luclu7/luclu-electronic/static/img/kvb/3bis-7seg-tm1637.jpg

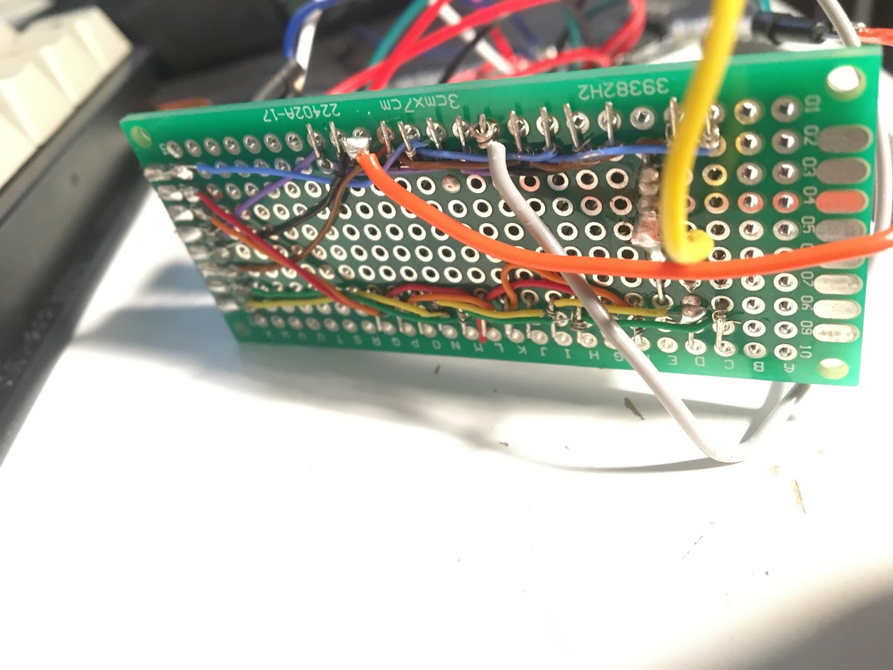
static/img/kvb/3bis-7seg-tm1637.jpg
