luclu7/luclu-electronic/static/img/kvb/7segments.jpg

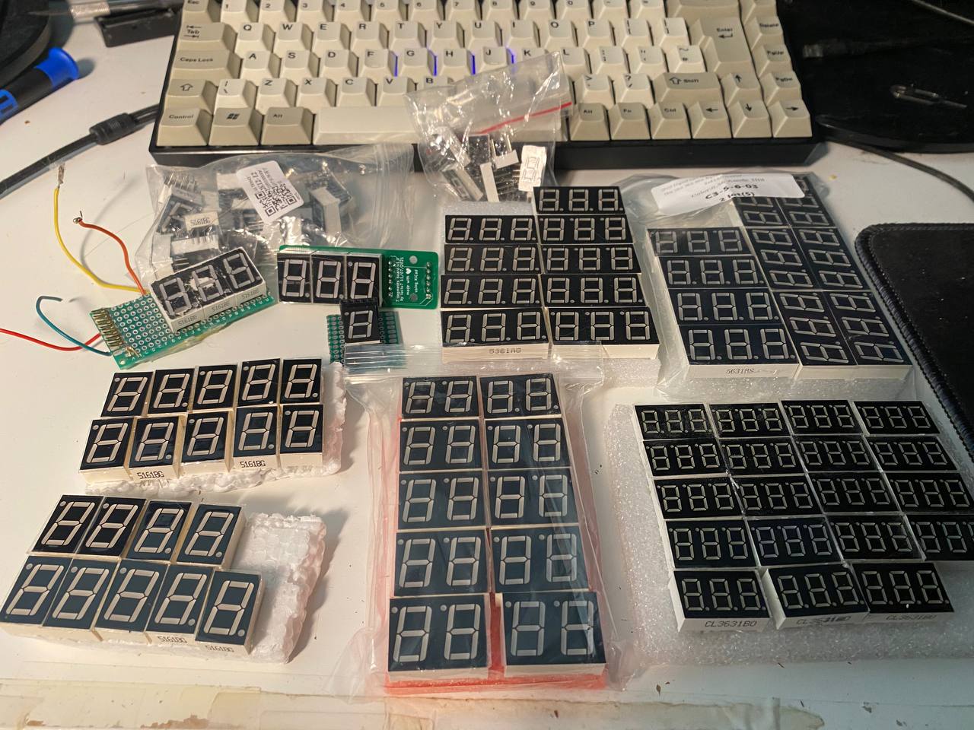
static/img/kvb/7segments.jpg
