luclu7/luclu-electronic/static/img/kvb/aliexpress-1.png

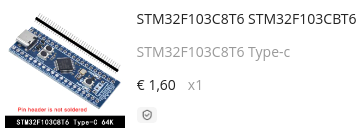
static/img/kvb/aliexpress-1.png
