luclu7/luclu-electronic/static/img/kvb/arriere-boitier-1.jpg

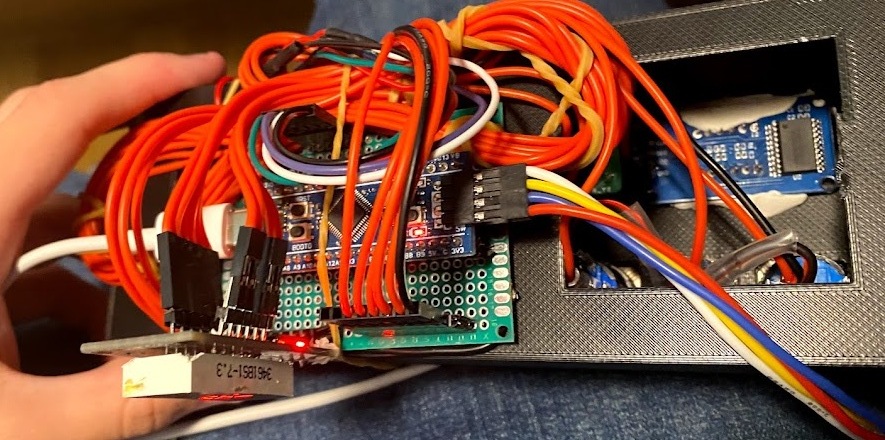
static/img/kvb/arriere-boitier-1.jpg
