luclu7/luclu-electronic/static/img/kvb/arriere-boitier-2.jpg

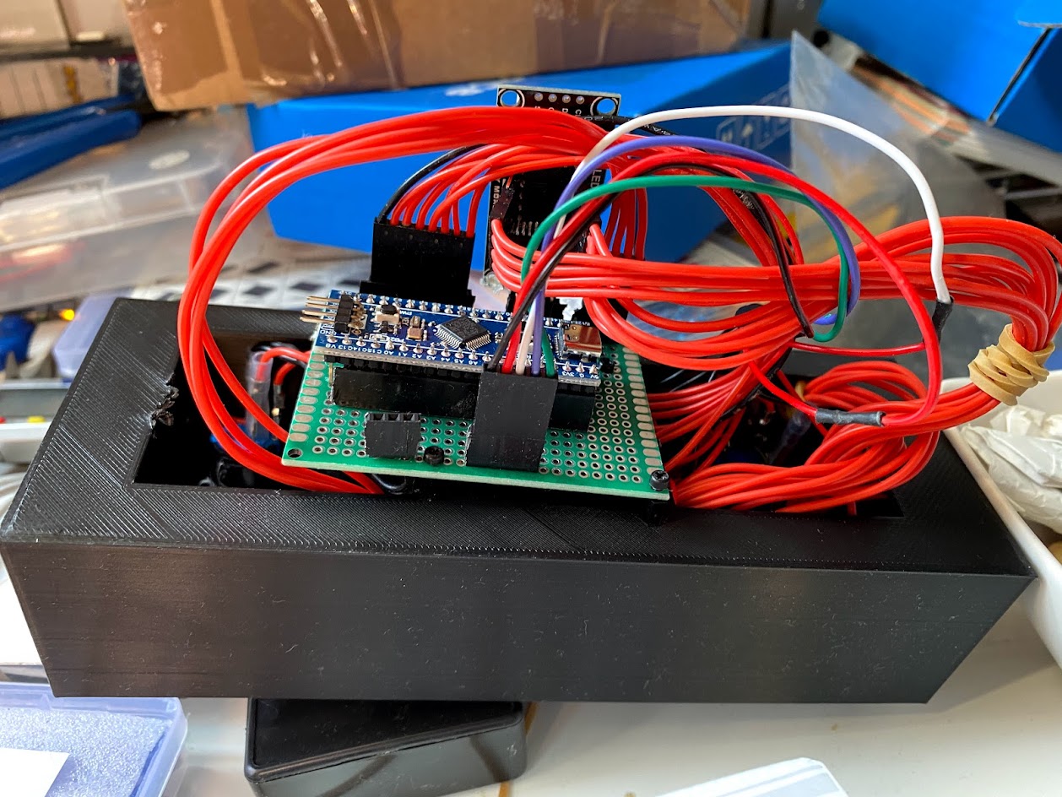
static/img/kvb/arriere-boitier-2.jpg
