luclu7/luclu-electronic/static/img/kvb/breadboard.jpg

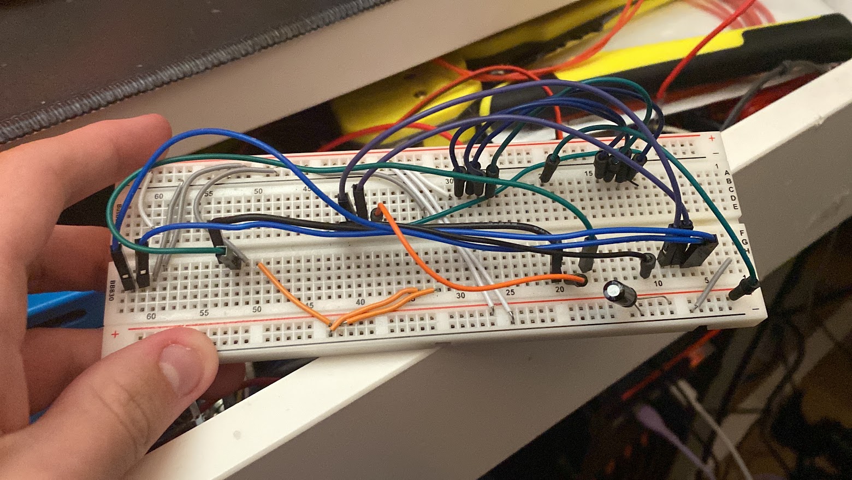
static/img/kvb/breadboard.jpg
