luclu7/luclu-electronic/static/img/kvb/kvb-1ere-impression.jpg

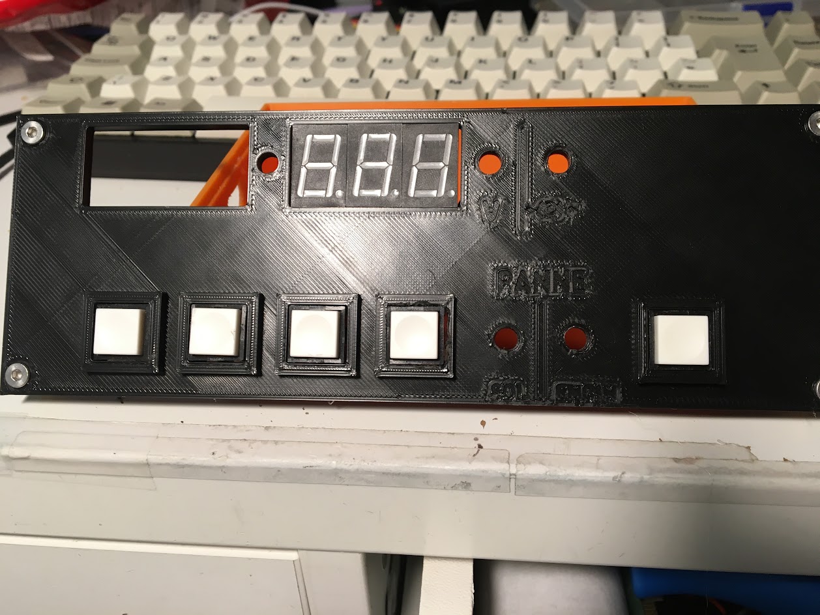
static/img/kvb/kvb-1ere-impression.jpg
