luclu7/luclu-electronic/static/img/kvb/kvb-20-mai.png

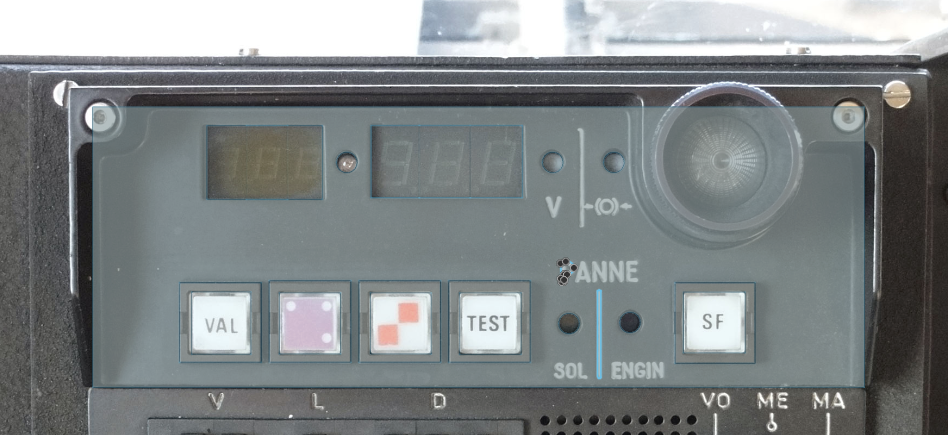
static/img/kvb/kvb-20-mai.png
