luclu7/luclu-electronic/static/img/kvb/kvb-29-mai.png

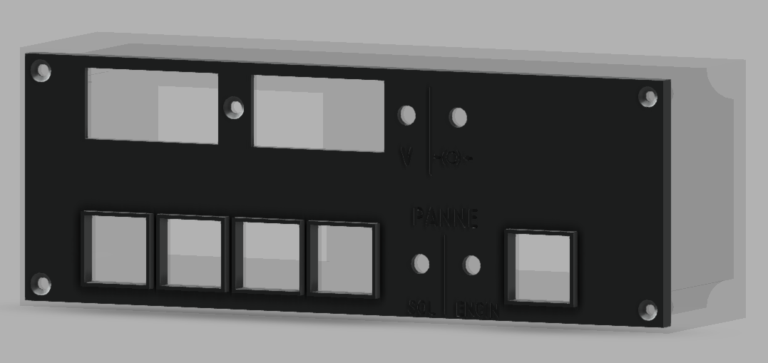
static/img/kvb/kvb-29-mai.png
