luclu7/luclu-electronic/static/img/kvb/kvb-final.jpg

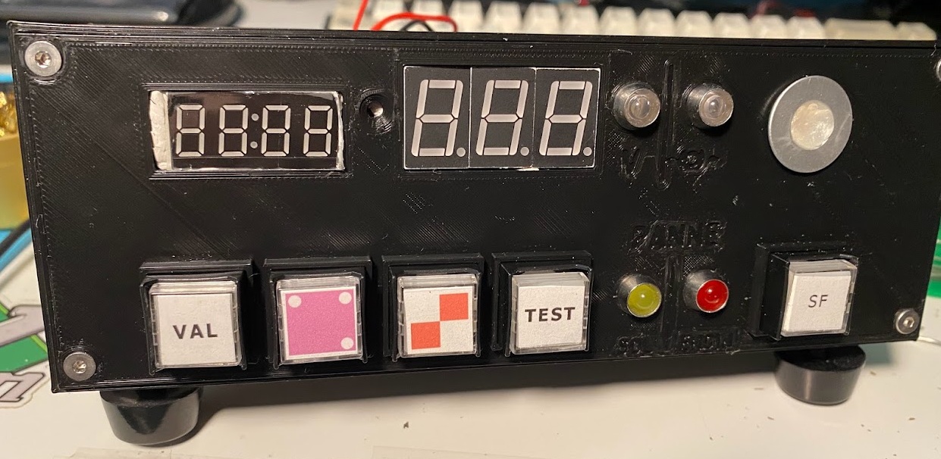
static/img/kvb/kvb-final.jpg
