luclu7/luclu-electronic/static/img/kvb/kvb-led.jpg

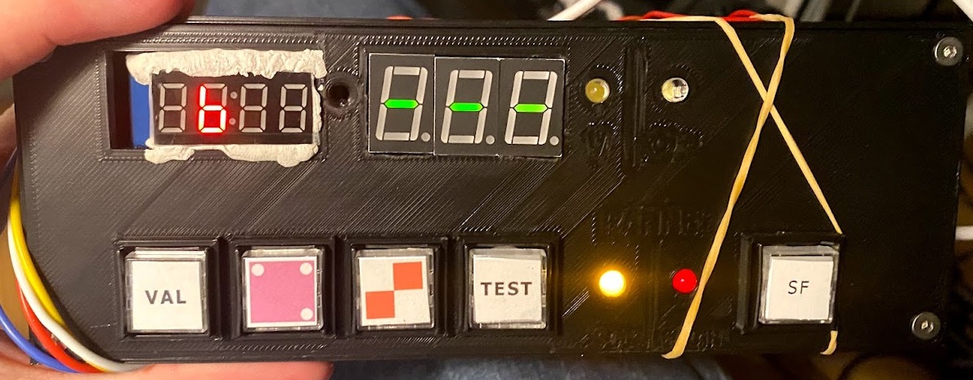
static/img/kvb/kvb-led.jpg
