luclu7/luclu-electronic/static/img/kvb/kvb-rio.jpg

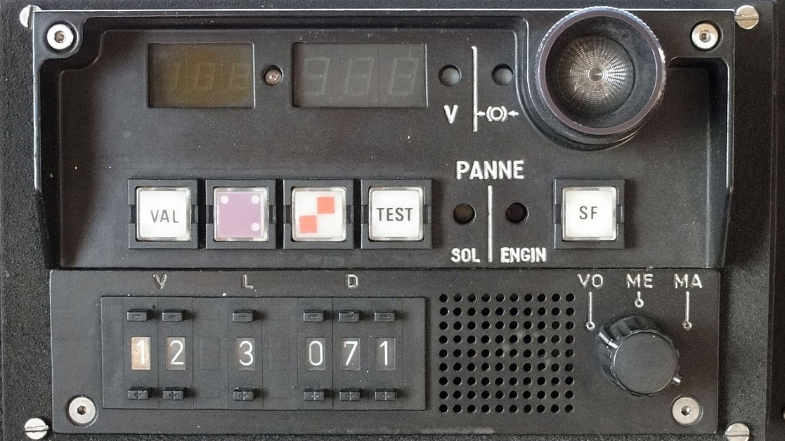
static/img/kvb/kvb-rio.jpg
