luclu7/luclu-electronic/static/img/kvb/kvb-sur-bureau.jpg

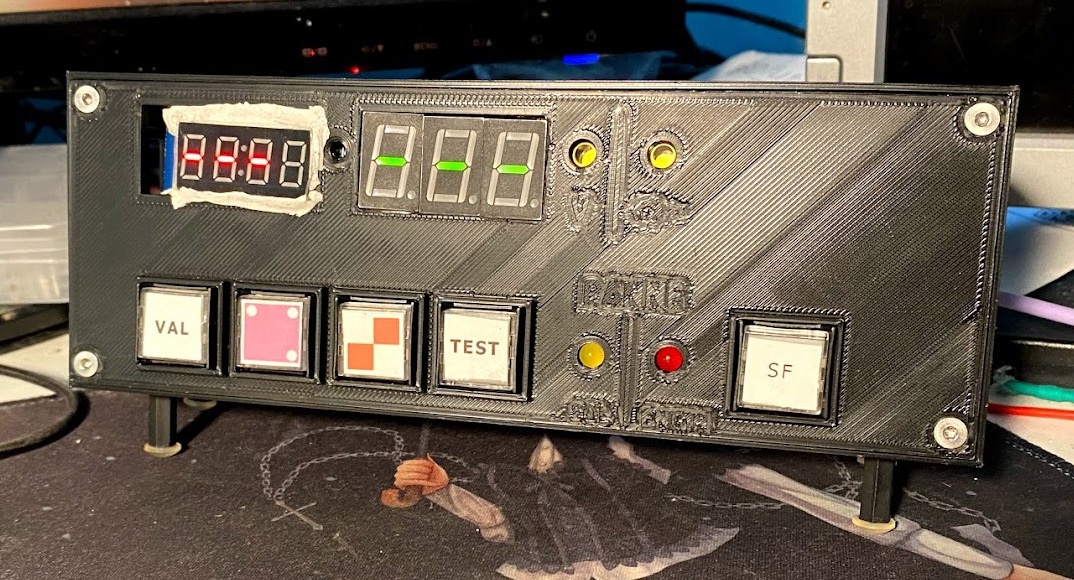
static/img/kvb/kvb-sur-bureau.jpg
