luclu7/luclu-electronic/static/img/kvb/kvb-ts-dans-train.jpg

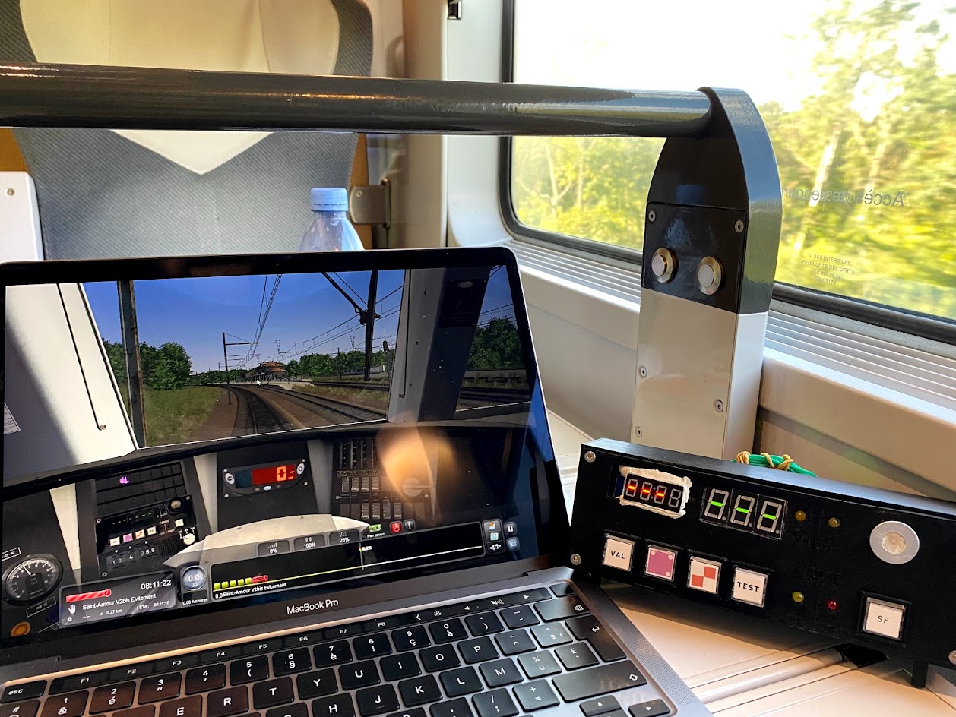
static/img/kvb/kvb-ts-dans-train.jpg
