luclu7/luclu-electronic/static/img/kvb/pcb1.png

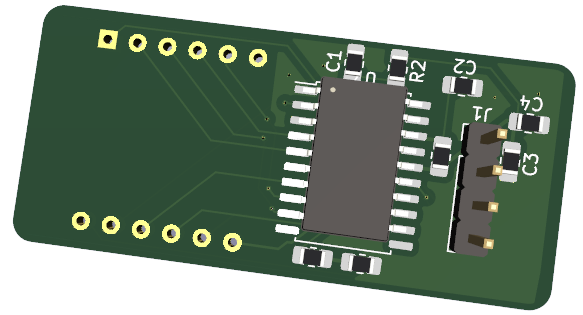
static/img/kvb/pcb1.png
