luclu7/luclu-electronic/static/img/kvb/pcb2.png

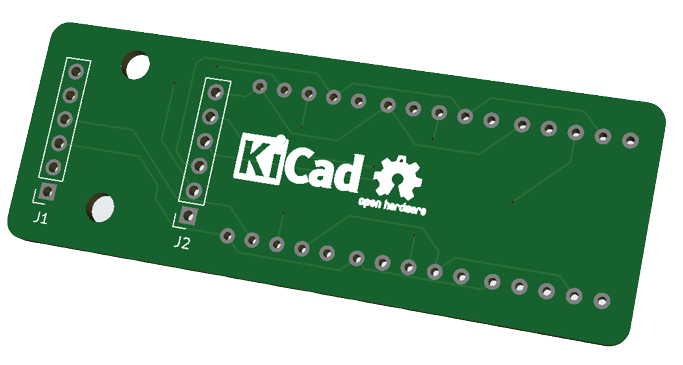
static/img/kvb/pcb2.png
