luclu7/luclu-electronic/static/img/kvb/pcb3.png

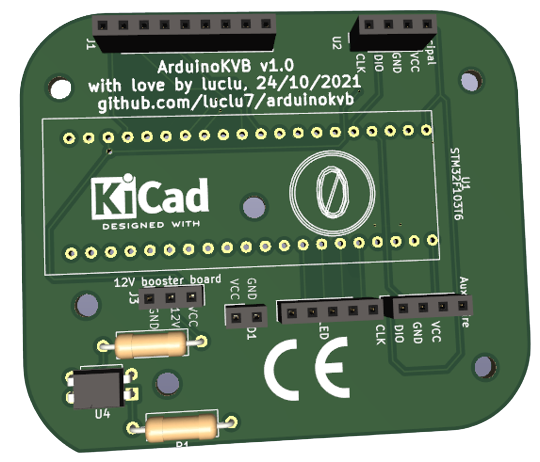
static/img/kvb/pcb3.png
