luclu7/luclu-electronic/static/img/kvb/pcb-trace-bodge-wire.jpg

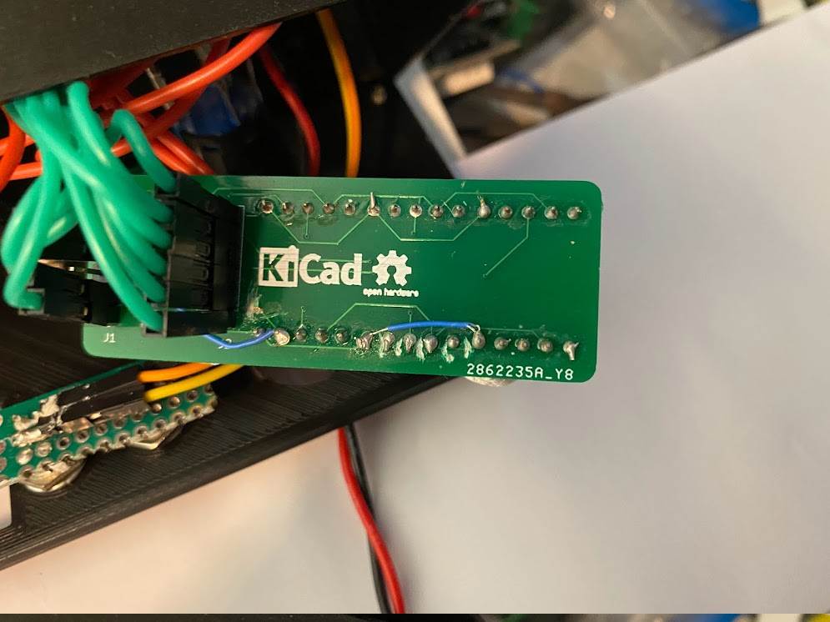
static/img/kvb/pcb-trace-bodge-wire.jpg
