luclu7/luclu-electronic/static/img/kvb/perfboard1.jpg

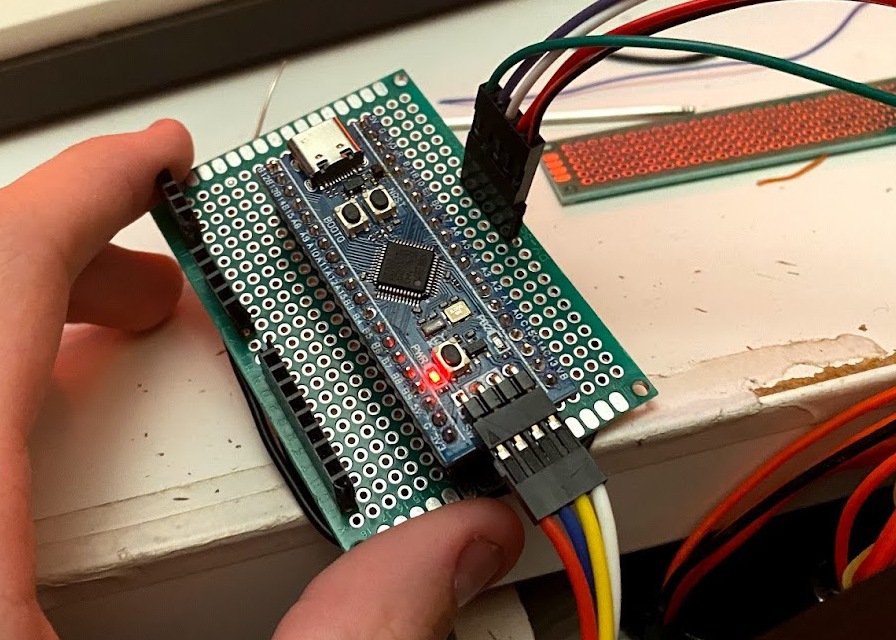
static/img/kvb/perfboard1.jpg
