luclu7/luclu-electronic/static/img/kvb/perfboard2.jpg

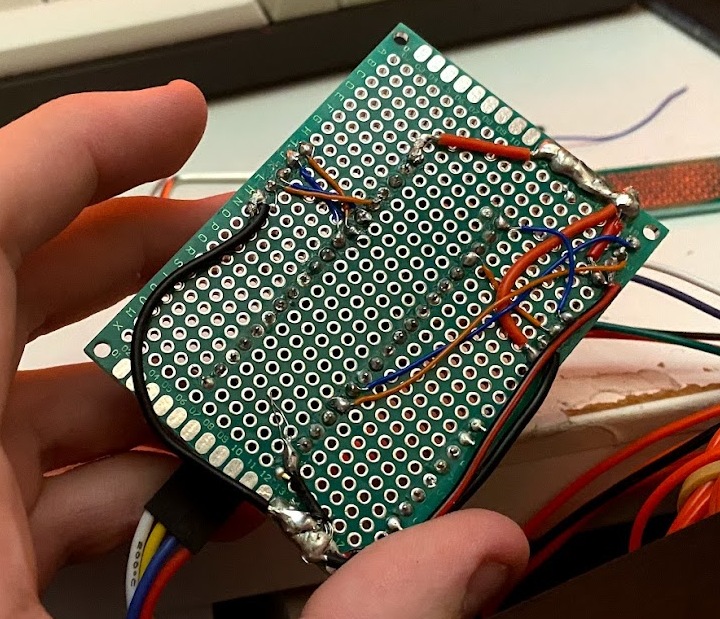
static/img/kvb/perfboard2.jpg
