luclu7/luclu-electronic/static/img/kvb/plaque.jpg

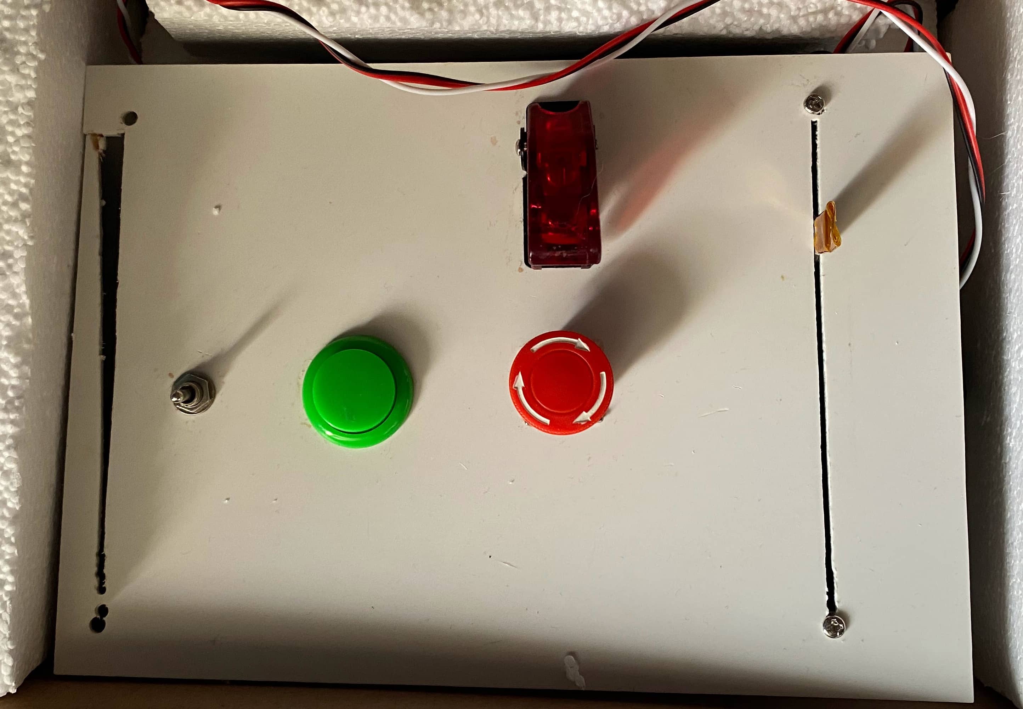
static/img/kvb/plaque.jpg
