luclu7/luclu-electronic/static/img/kvb/pupitre-72000-ferrovisim.jpg

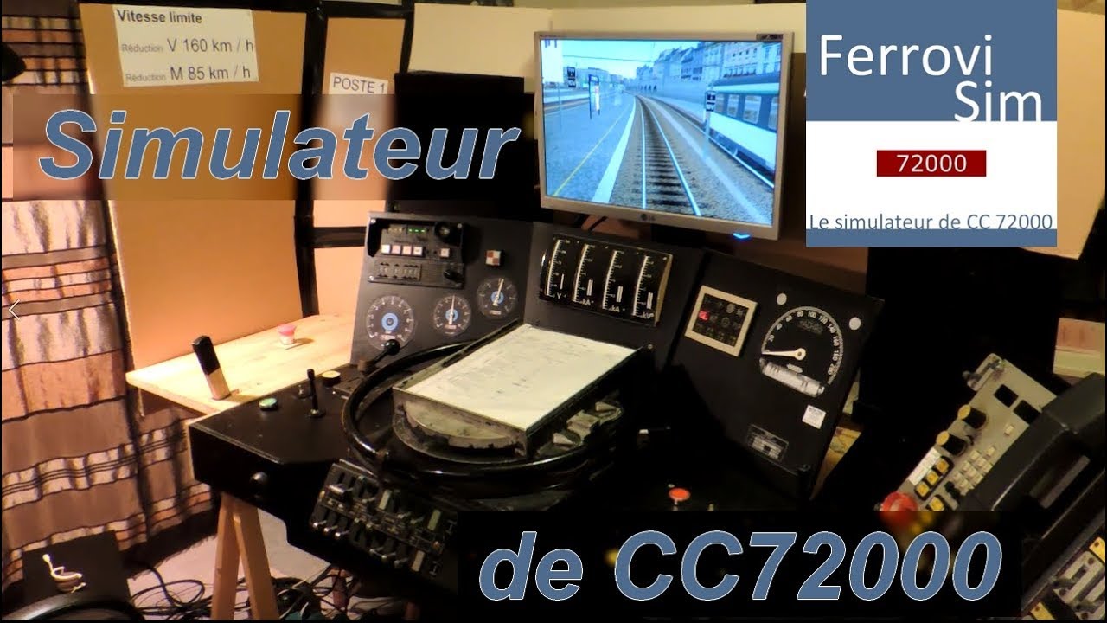
static/img/kvb/pupitre-72000-ferrovisim.jpg
