luclu7/luclu-electronic/static/img/kvb/pédale_avec_connecteur.jpg

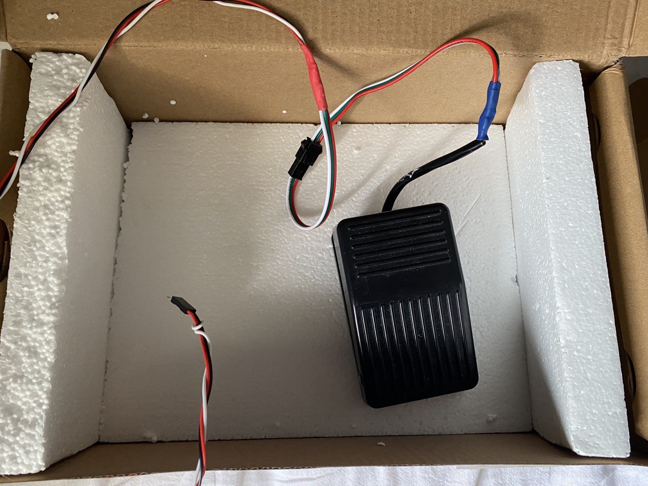
static/img/kvb/pédale_avec_connecteur.jpg
