luclu7/luclu-electronic/static/img/kvb/raildriver.png

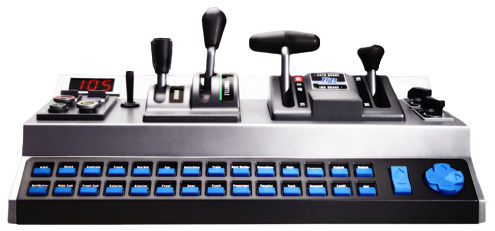
static/img/kvb/raildriver.png
