luclu7/luclu-electronic/static/img/kvb/schema-pcb-final.png

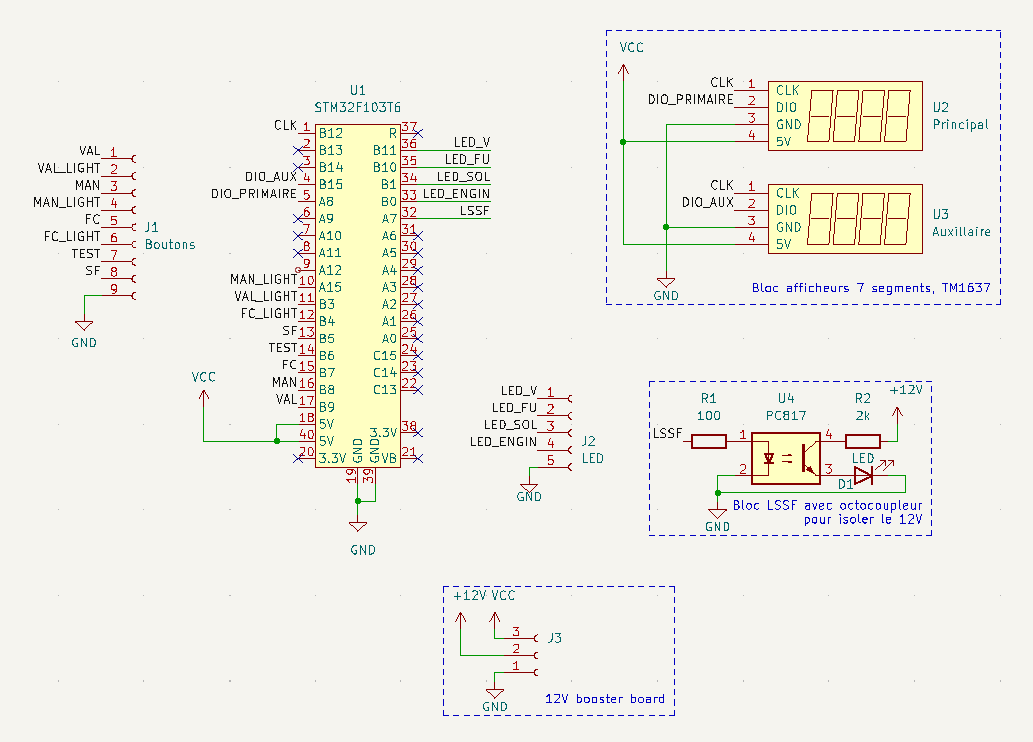
static/img/kvb/schema-pcb-final.png
