luclu7/luclu-electronic/static/img/kvb/slide_pot.png

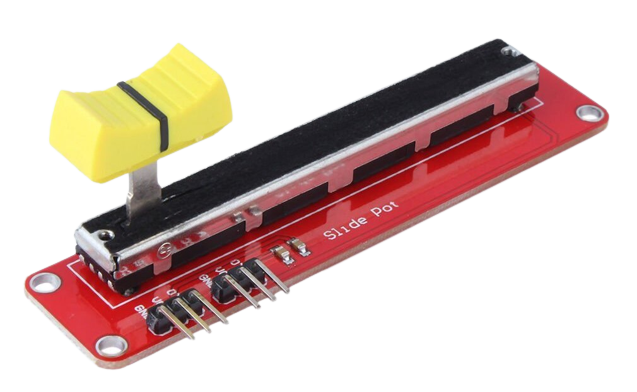
static/img/kvb/slide_pot.png
