luclu7/luclu-electronic/static/img/kvb/thumbnail.png

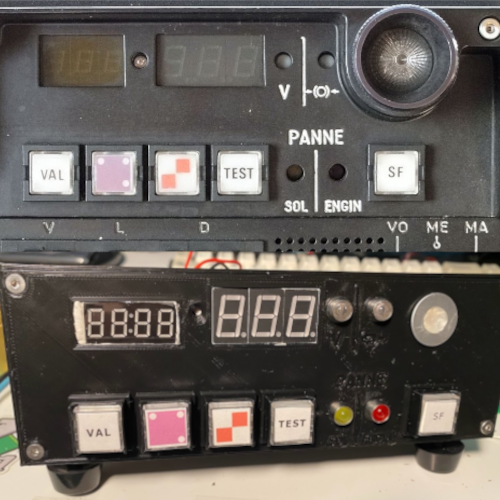
static/img/kvb/thumbnail.png
