luclu7/luclu-electronic/static/img/kvb/tm1637-green.png

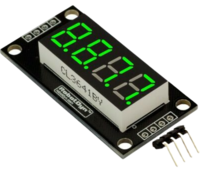
static/img/kvb/tm1637-green.png
