luclu7/luclu-electronic/static/img/kvb/KVB-mai.stp

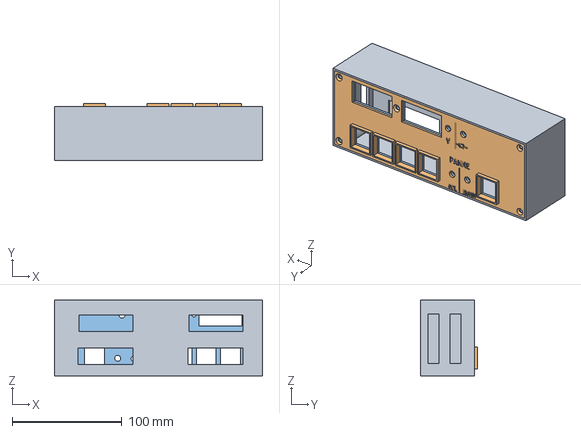
[picture p34: CAD file, 2022-08-06]
static/img/kvb/KVB-mai.stp
189.3 x 52.0 x 68.8 mm
