luclu7/luclu-electronic/static/img/kvb/KVB.stp

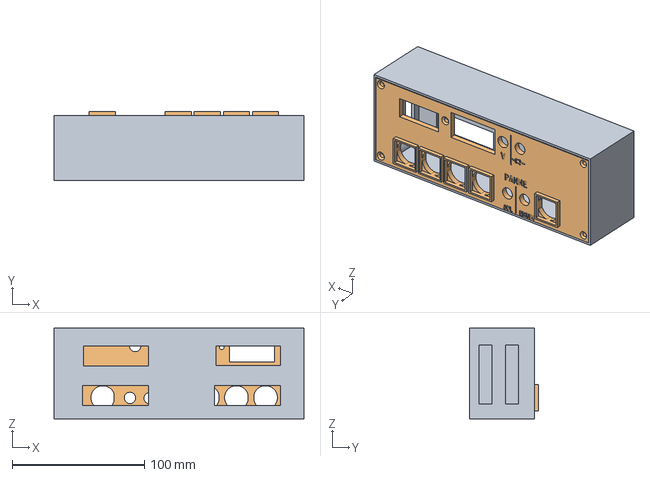
[picture p35: CAD file, 2022-08-06]
static/img/kvb/KVB.stp
189.3 x 52.0 x 68.8 mm
